Daniel-Alencar/MiniEasy/bom.csv

Referencias | Valor | Footprint | Qtd
C1 | 100u/25V | Capacitor_SMD:CP_Elec_6.3x7.7 | 1
C2 | 10u/25V | Capacitor_SMD:C_0805_2012Metric | 1
C3 | 10u | Capacitor_SMD:C_0805_2012Metric | 1
C4,C5,C6,C7,C9,C11,C12,C13,C15 | 100n | Capacitor_SMD:C_0603_1608Metric | 9
C8,C10,C14 | 1u | Capacitor_SMD:C_0603_1608Metric | 3
C16,C17 | 10n | Capacitor_SMD:C_0603_1608Metric | 2
D1,D2,D3 | B5819W | Diode_SMD:D_SOD-123 | 3
D4 | LED verde | LED_SMD:LED_0603_1608Metric | 1
J1 | BAT 4-16 V | TerminalBlock_MetzConnect:TerminalBlock_MetzConnect_Type059_RT06302HBWC_1x02_P3.50mm_Horizontal | 1
J2 | SWD | Connector_PinHeader_1.27mm:PinHeader_1x05_P1.27mm_Vertical | 1
J3 | USB micro-B | Connector_USB:USB_Micro-B_Molex_47346-0001 | 1
J4 | PIRO APOGEU | TerminalBlock_MetzConnect:TerminalBlock_MetzConnect_Type059_RT06302HBWC_1x02_P3.50mm_Horizontal | 1
J5 | PIRO PRINCIPAL | TerminalBlock_MetzConnect:TerminalBlock_MetzConnect_Type059_RT06302HBWC_1x02_P3.50mm_Horizontal | 1
LS1 | CMT-8504-100-SMT | Buzzer_Beeper:MagneticBuzzer_CUI_CMT-8504-100-SMT | 1
Q1,Q2 | AO3400A | Package_TO_SOT_SMD:SOT-23 | 2
Q3 | BSS138 | Package_TO_SOT_SMD:SOT-23 | 1
R1,R6,R7,R9,R10,R13,R14,R17 | 100k | Resistor_SMD:R_0603_1608Metric | 8
R2,R3,R4,R5,R11,R15 | 10k | Resistor_SMD:R_0603_1608Metric | 6
R8,R12,R16 | 100R | Resistor_SMD:R_0603_1608Metric | 3
R18 | 1k | Resistor_SMD:R_0603_1608Metric | 1
U1 | MCP1703A-3302E/MB | Package_TO_SOT_SMD:SOT-89-3 | 1
U2 | STM32F042K6T6 | Package_QFP:LQFP-32_7x7mm_P0.8mm | 1
U3 | MS5607-02BA03 | Package_LGA:LGA-8_3x5mm_P1.25mm | 1
U4 | W25Q16JVSSIQ | Package_SO:SOIC-8_5.3x5.3mm_P1.27mm | 1
U5 | USBLC6-2SC6 | Package_TO_SOT_SMD:SOT-23-6 | 1
