Daniel-Alencar/MiniEasy/fabricacao/altimetro-topo.png

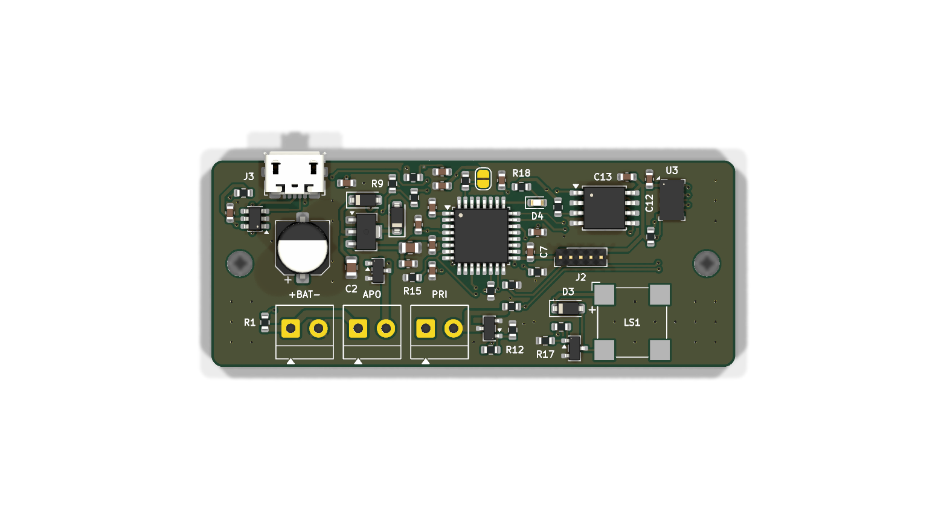
fabricacao/altimetro-topo.png
