Daniel-Alencar/MiniEasy/fabricacao/altimetro-verso.png

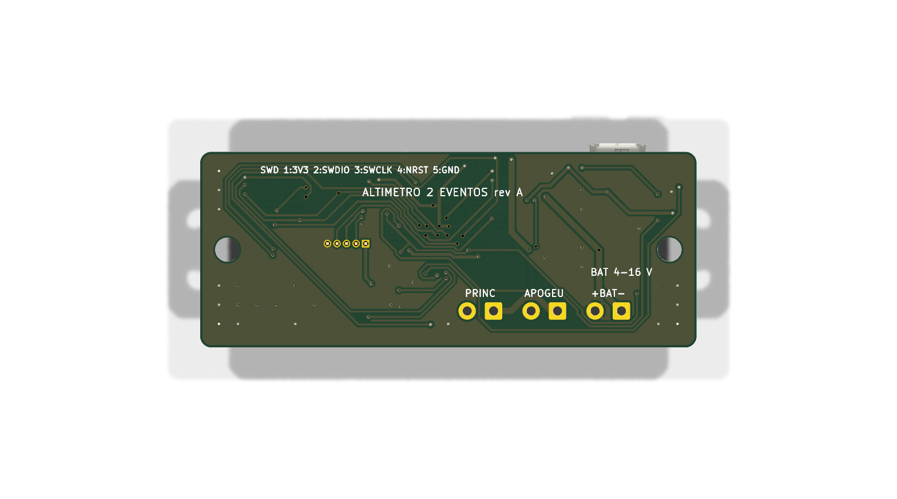
fabricacao/altimetro-verso.png
