Daniel-Alencar/MiniEasy/fabricacao/altimetro-montagem.pdf

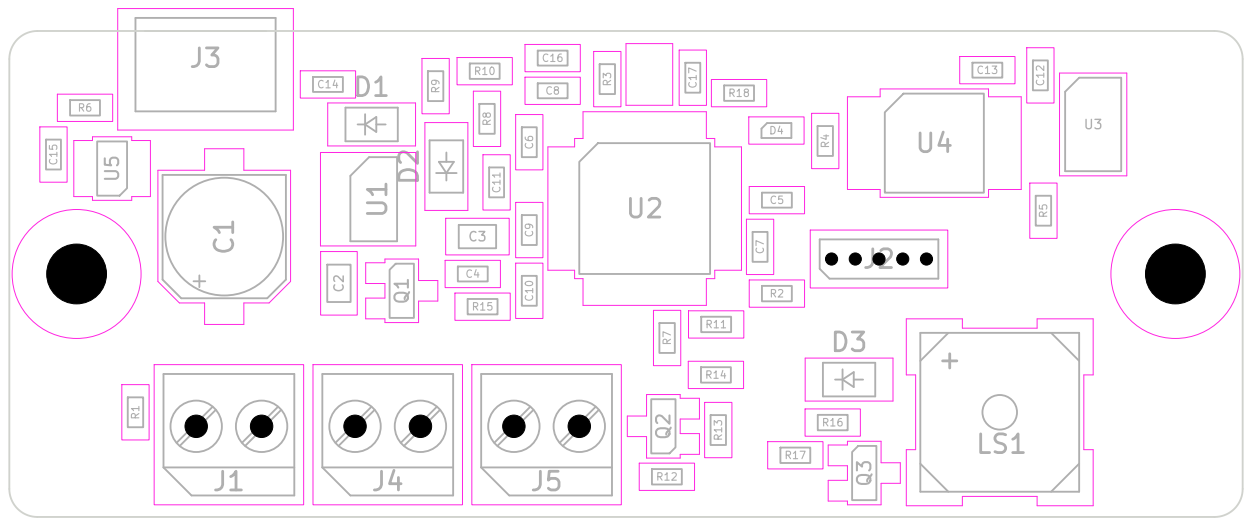
[picture p4: page 1]
