Daniel-Alencar/MiniEasy/altimetro.kicad_pcb

## KiCad design altimetro.kicad_pcb (2026-10-18)

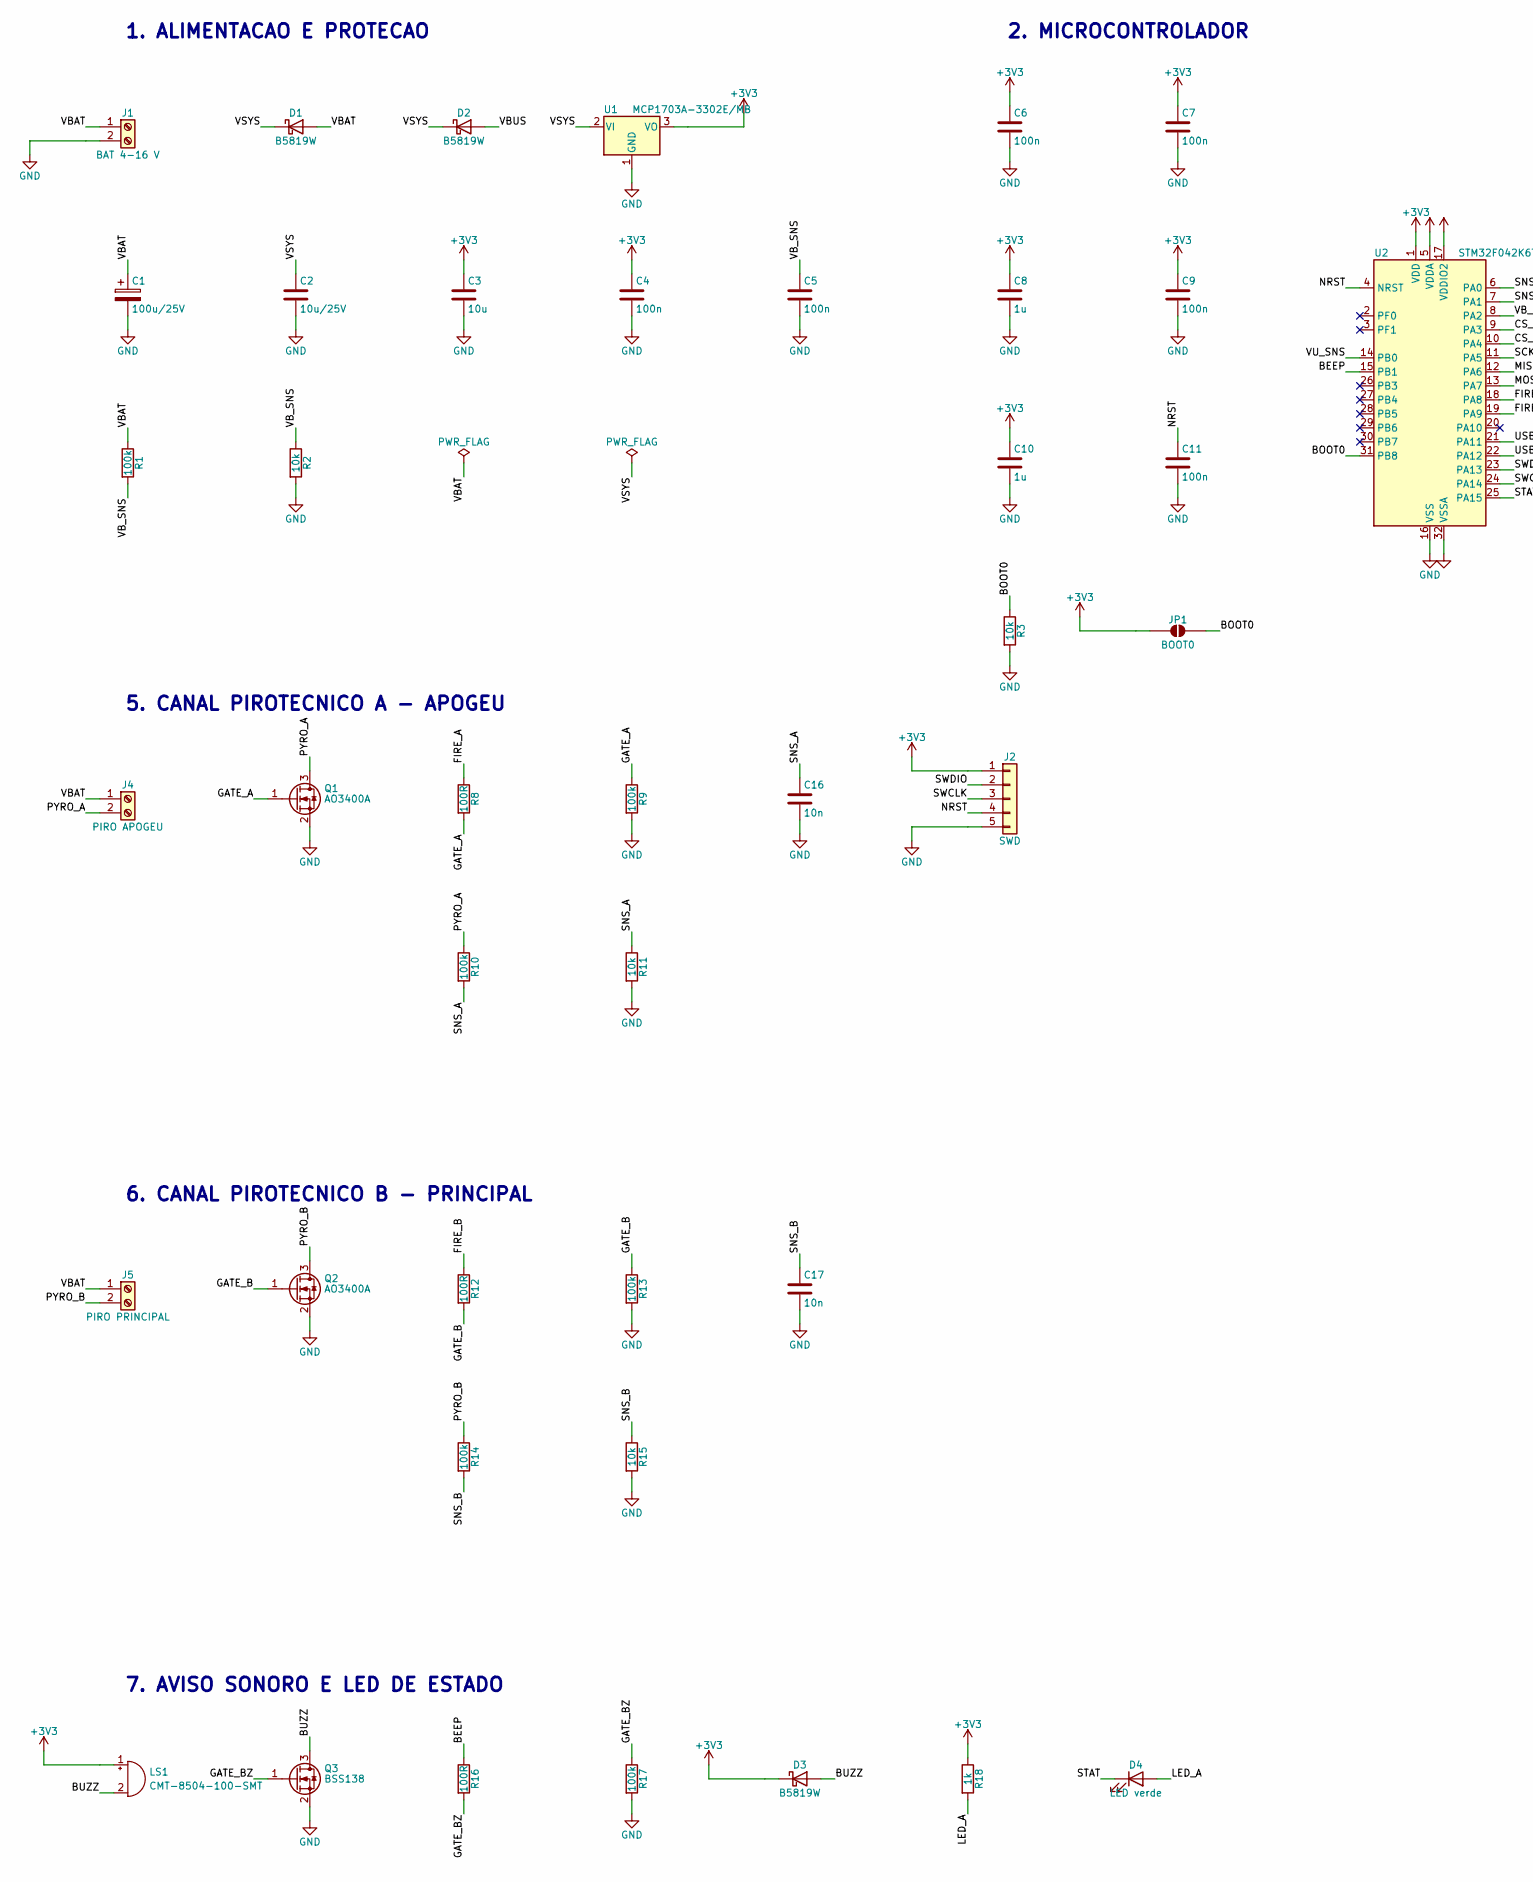
[picture p5: schematic altimetro.kicad_sch, Altimetro de dois eventos - classe EasyMini, part in row 1, column 1]

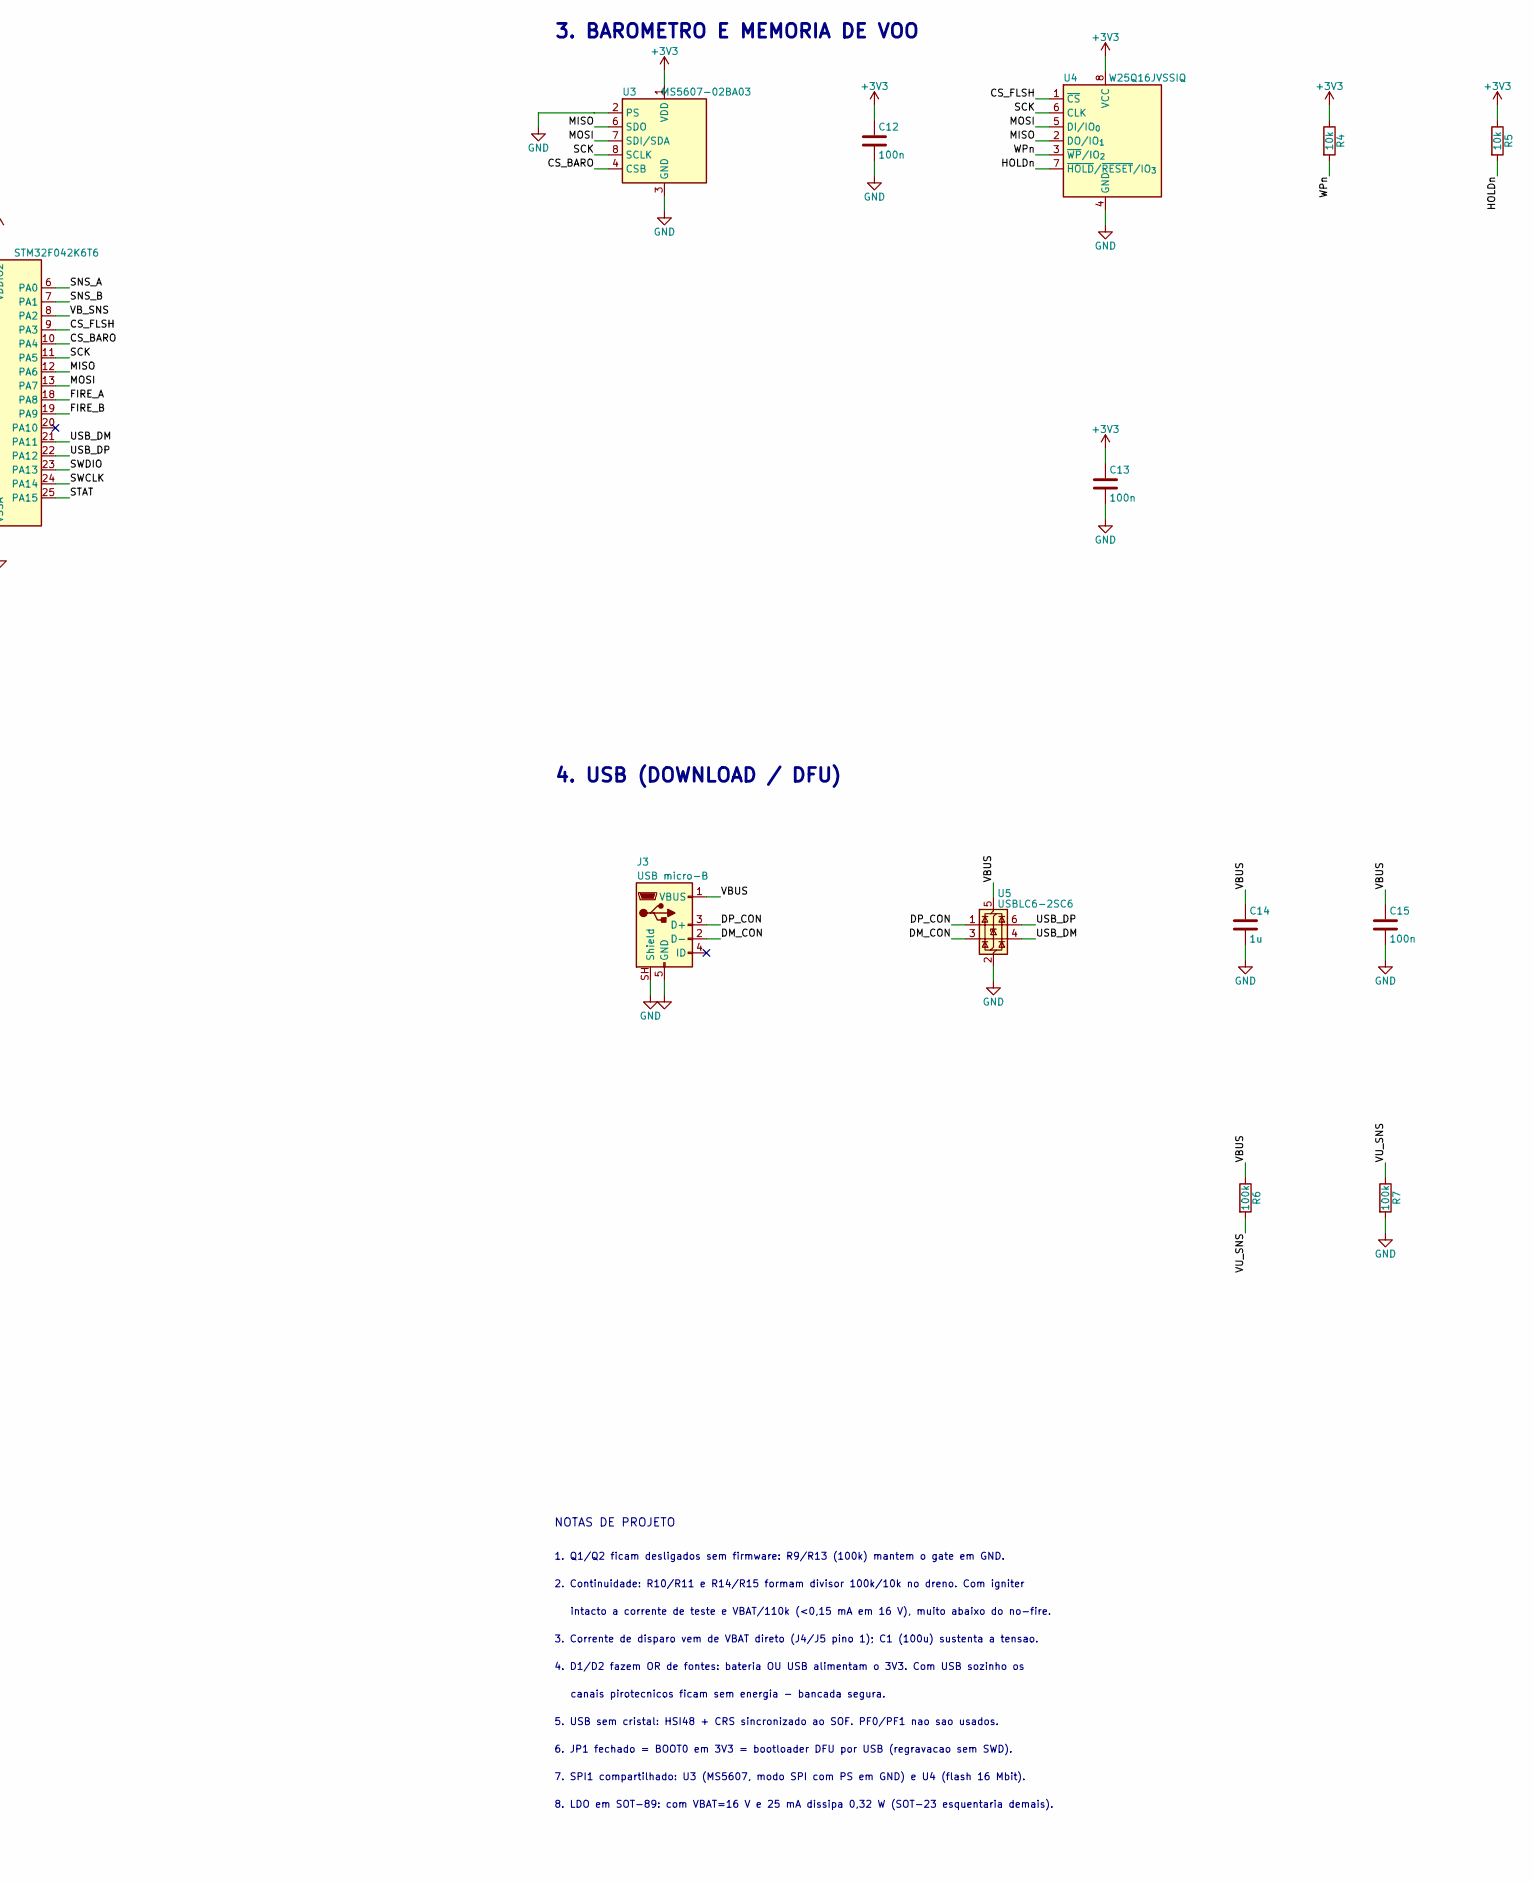
[picture p6: schematic altimetro.kicad_sch, Altimetro de dois eventos - classe EasyMini, part in row 1, column 2]

Parts:
C1: 100u/25V; CP_Elec_6.3x7.7
C2: 10u/25V; C_0805_2012Metric
C3: 10u; C_0805_2012Metric
C4, C5, C6, C7, C9, C11, C12, C13, C15: 100n; C_0603_1608Metric
C8, C10, C14: 1u; C_0603_1608Metric
C16, C17: 10n; C_0603_1608Metric
D1, D2, D3: B5819W; D_SOD-123
D4: LED verde; LED_0603_1608Metric
J1: BAT 4-16 V; TerminalBlock_MetzConnect_Type059_RT06302HBWC_1x02_P3.50mm_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
J2: SWD; PinHeader_1x05_P1.27mm_Vertical
J3: USB micro-B; USB_Micro-B_Molex_47346-0001
J4: PIRO APOGEU; TerminalBlock_MetzConnect_Type059_RT06302HBWC_1x02_P3.50mm_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
J5: PIRO PRINCIPAL; TerminalBlock_MetzConnect_Type059_RT06302HBWC_1x02_P3.50mm_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
JP1: BOOT0; SolderJumper-2_P1.3mm_Open_RoundedPad1.0x1.5mm
LS1: CMT-8504-100-SMT; MagneticBuzzer_CUI_CMT-8504-100-SMT
Q1, Q2: AO3400A; SOT-23
Q3: BSS138; SOT-23
R1, R6, R7, R9, R10, R13, R14, R17: 100k; R_0603_1608Metric
R2, R3, R4, R5, R11, R15: 10k; R_0603_1608Metric
R8, R12, R16: 100R; R_0603_1608Metric
R18: 1k; R_0603_1608Metric
U1: MCP1703A-3302E/MB; SOT-89-3
U2: STM32F042K6T6; LQFP-32_7x7mm_P0.8mm
U3: MS5607-02BA03; LGA-8_3x5mm_P1.25mm
U4: W25Q16JVSSIQ; SOIC-8_5.3x5.3mm_P1.27mm
U5: USBLC6-2SC6; SOT-23-6

Connections:
+3V3: C3.1, C4.1, C6.1, C7.1, C8.1, C9.1, C10.1, C12.1, C13.1, D3.1 (K), J2.1, JP1.1 (A), LS1.1 (+), R4.1, R5.1, R18.1, U1.3 (VO), U2.1 (VDD), U2.5 (VDDA), U2.17 (VDDIO2), U3.1 (VDD), U4.8 (VCC)
/BEEP: R16.1, U2.15 (PB1)
/BOOT0: JP1.2 (B), R3.1, U2.31 (PB8)
/BUZZ: D3.2 (A), LS1.2 (-), Q3.3 (D)
/CS_BARO: U2.10 (PA4), U3.4 (CSB), U3.5 (CSB)
/CS_FLSH: U2.9 (PA3), U4.1 (~CS)
/DM_CON: J3.2 (D-), U5.3 (I/O2)
/DP_CON: J3.3 (D+), U5.1 (I/O1)
/FIRE_A: R8.1, U2.18 (PA8)
/FIRE_B: R12.1, U2.19 (PA9)
/GATE_A: Q1.1 (G), R8.2, R9.1
/GATE_B: Q2.1 (G), R12.2, R13.1
/GATE_BZ: Q3.1 (G), R16.2, R17.1
/HOLDn: R5.2, U4.7 (~HOLD/~RESET/IO_{3})
/LED_A: D4.2 (A), R18.2
/MISO: U2.12 (PA6), U3.6 (SDO), U4.2 (DO/IO_{1})
/MOSI: U2.13 (PA7), U3.7 (SDI/SDA), U4.5 (DI/IO_{0})
/NRST: C11.1, J2.4, U2.4 (NRST)
/PYRO_A: J4.2, Q1.3 (D), R10.1
/PYRO_B: J5.2, Q2.3 (D), R14.1
/SCK: U2.11 (PA5), U3.8 (SCLK), U4.6 (CLK)
/SNS_A: C16.1, R10.2, R11.1, U2.6 (PA0)
/SNS_B: C17.1, R14.2, R15.1, U2.7 (PA1)
/STAT: D4.1 (K), U2.25 (PA15)
/SWCLK: J2.3, U2.24 (PA14)
/SWDIO: J2.2, U2.23 (PA13)
/USB_DM: U2.21 (PA11), U5.4 (I/O2)
/USB_DP: U2.22 (PA12), U5.6 (I/O1)
/VBAT: C1.1, D1.2 (A), J1.1, J4.1, J5.1, R1.1
/VBUS: C14.1, C15.1, D2.2 (A), J3.1 (VBUS), R6.1, U5.5 (VBUS)
/VB_SNS: C5.1, R1.2, R2.1, U2.8 (PA2)
/VSYS: C2.1, D1.1 (K), D2.1 (K), U1.2 (VI)
/VU_SNS: R6.2, R7.1, U2.14 (PB0)
/WPn: R4.2, U4.3 (~WP/IO_{2})
GND: C1.2, C2.2, C3.2, C4.2, C5.2, C6.2, C7.2, C8.2, C9.2, C10.2, C11.2, C12.2, C13.2, C14.2, C15.2, C16.2, C17.2, J1.2, J2.5, J3.5 (GND), J3.SH (Shield), Q1.2 (S), Q2.2 (S), Q3.2 (S), R2.2, R3.2, R7.2, R9.2, R11.2, R13.2, R15.2, R17.2, U1.1 (GND), U2.16 (VSS), U2.32 (VSSA), U3.2 (PS), U3.3 (GND), U4.4 (GND), U5.2 (GND)

Notes on the sheet:
8. LDO em SOT-89: com VBAT=16 V e 25 mA dissipa 0,32 W (SOT-23 esquentaria demais).
4. D1/D2 fazem OR de fontes: bateria OU USB alimentam o 3V3. Com USB sozinho os
2. MICROCONTROLADOR
intacto a corrente de teste e VBAT/110k (<0,15 mA em 16 V), muito abaixo do no-fire.
3. BAROMETRO E MEMORIA DE VOO
1. Q1/Q2 ficam desligados sem firmware: R9/R13 (100k) mantem o gate em GND.
4. USB (DOWNLOAD / DFU)
7. SPI1 compartilhado: U3 (MS5607, modo SPI com PS em GND) e U4 (flash 16 Mbit).
6. JP1 fechado = BOOT0 em 3V3 = bootloader DFU por USB (regravacao sem SWD).
3. Corrente de disparo vem de VBAT direto (J4/J5 pino 1); C1 (100u) sustenta a tensao.
2. Continuidade: R10/R11 e R14/R15 formam divisor 100k/10k no dreno. Com igniter
NOTAS DE PROJETO
canais pirotecnicos ficam sem energia - bancada segura.
6. CANAL PIROTECNICO B - PRINCIPAL
5. USB sem cristal: HSI48 + CRS sincronizado ao SOF. PF0/PF1 nao sao usados.
7. AVISO SONORO E LED DE ESTADO
5. CANAL PIROTECNICO A - APOGEU
1. ALIMENTACAO E PROTECAO

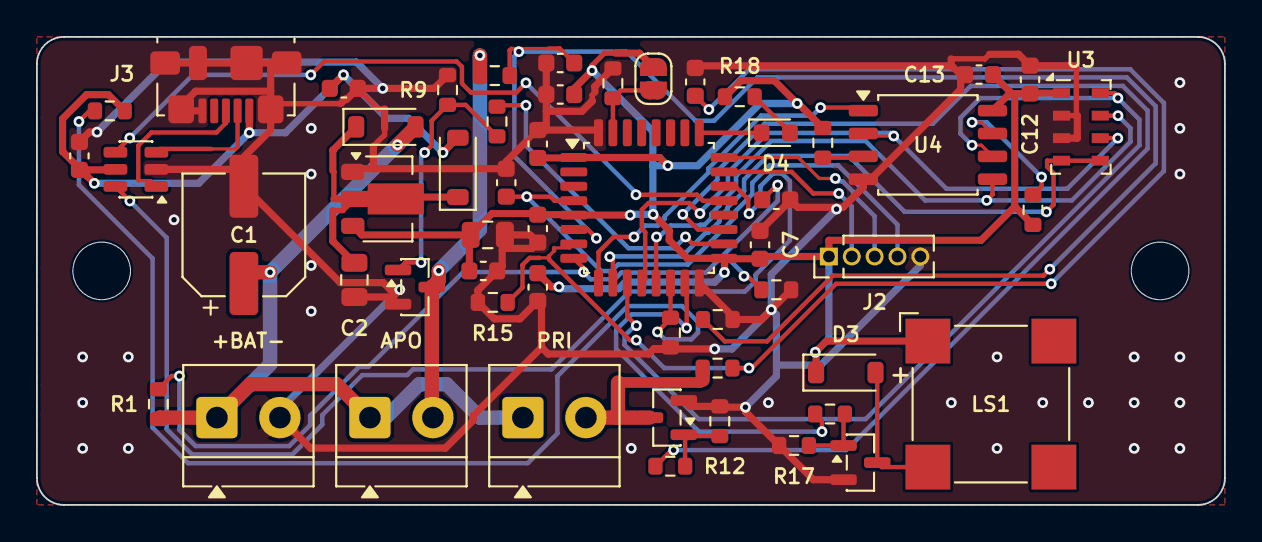
[picture p7: board altimetro.kicad_pcb from above]

Board: 2 copper layers, 66.0 x 26.0 mm, 56 parts (0 on the bottom side), 35 nets.

Other parts of the board:
H1, H2: M3; MountingHole_3.2mm_M3
