Daniel-Alencar/MiniEasy/(commit log)

2026-10-17 feat: initial commit
    [altimetro.kicad_sch, bom.csv]
2026-10-18 feat: PCB feita
    [altimetro-B_Cu.gbl, altimetro-B_Mask.gbs, altimetro-B_Paste.gbp, altimetro-B_Silkscreen.gbo, altimetro-Edge_Cuts.gm1, altimetro-F_Cu.gtl, altimetro-F_Mask.gts, altimetro-F_Paste.gtp]
